fanfanlatulipe26/BaliseDGAC_GPS_Logger/img/detail_balise - Copie.jpg

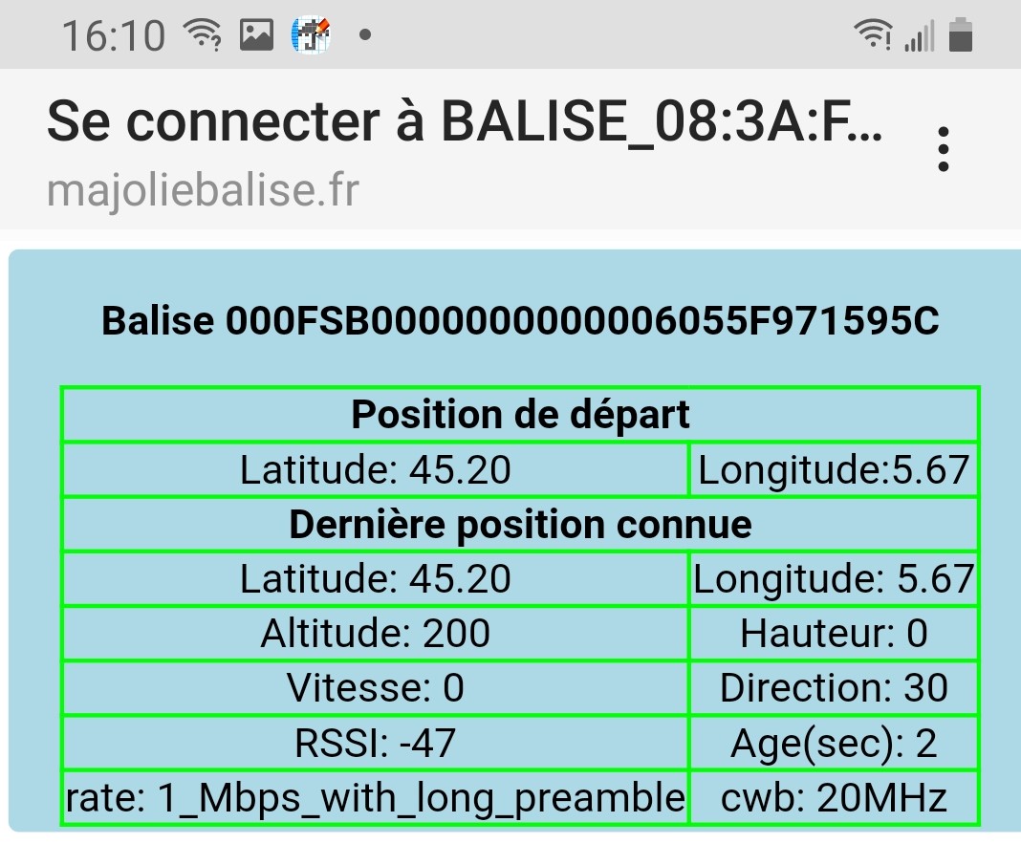
img/detail_balise - Copie.jpg
