fanfanlatulipe26/BaliseDGAC_GPS_Logger/img/recepteur_2.jpg

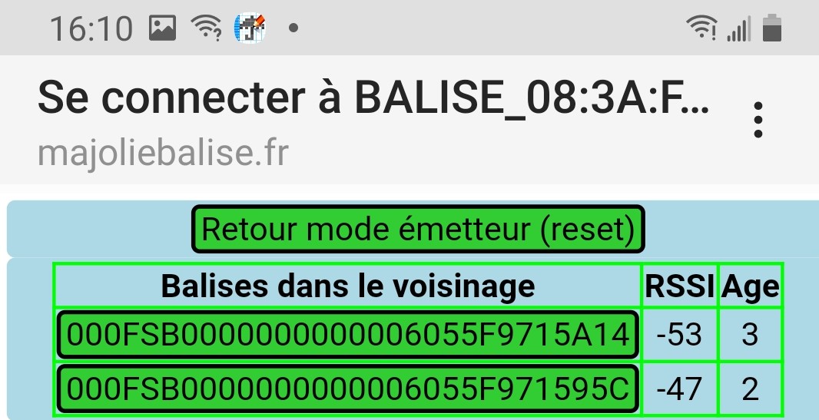
img/recepteur_2.jpg
