fanfanlatulipe26/BaliseDGAC_GPS_Logger/(threads)

Thread 6 (2023-06-19):

Pb déclaration lib SoftwareSerial.h + GPS_RX_PIN

dev-fred, 2023-06-19:
Bonjour,
Merci pour cette application très riche en fonctionnalité.
En utilisation sur ESP32 pas de problème mais sur ESP8266 D1 Mini 2 problèmes :
Mon contexte
//  Options logiciel.
#define fs_OTA        // pour permettre une mise a jour OTA pour logiciel
//#define fs_RECEPTEUR  // pour inclure aussi le code récepteur (uniquement pour une carte à base ESP32 / ESP32C3)
//#define repondeurGSM  // pour envoyer dans un SMS la position avec une module GSM SIM800L (uniquement pour une carte à base ESP32 / ESP32C3)
//#define fs_STAT     // pour avoir une page de statisques,durée exécution, erreurs GPS, etc ...Utile en phase développement ..

1) La compilation produit ces erreurs liées à un problème de déclaration de la librairie SoftSerial.h :

C:\Users\devfr\Downloads\BaliseDGAC_GPS_Logger-main\BaliseDGAC_GPS_Logger-main.ino:45:17: note: '#pragma message: Compilation pour ESP8266 !'
   45 | #pragma message "Compilation pour ESP8266 !"
      |                 ^~~~~~~~~~~~~~~~~~~~~~~~~~~~

BaliseDGAC_GPS_Logger-main:226:1: error: 'SoftwareSerial' does not name a type; did you mean 'HardwareSerial'?
  226 | SoftwareSerial serialGPS;  // pour ESP8266   softwareserial uniquement
      | ^~~~~~~~~~~~~~
      | HardwareSerial
C:\Users\devfr\Downloads\BaliseDGAC_GPS_Logger-main\BaliseDGAC_GPS_Logger-main.ino:227:17: note: '#pragma message: Utilisation de SoftwareSerial pour GPS !'
  227 | #pragma message "Utilisation de SoftwareSerial pour GPS !"
      |                 ^~~~~~~~~~~~~~~~~~~~~~~~~~~~~~~~~~~~~~~~~~
C:\Users\devfr\Downloads\BaliseDGAC_GPS_Logger-main\BaliseDGAC_GPS_Logger-main.ino: In function 'void setup()':
BaliseDGAC_GPS_Logger-main:526:3: error: 'serialGPS' was not declared in this scope
  526 |   serialGPS.begin(9600, SWSERIAL_8N1, GPS_RX_PIN, GPS_TX_PIN );
      |   ^~~~~~~~~
BaliseDGAC_GPS_Logger-main:526:25: error: 'SWSERIAL_8N1' was not declared in this scope; did you mean 'SERIAL_8N1'?
  526 |   serialGPS.begin(9600, SWSERIAL_8N1, GPS_RX_PIN, GPS_TX_PIN );
      |                         ^~~~~~~~~~~~
      |                         SERIAL_8N1
C:\Users\devfr\Downloads\BaliseDGAC_GPS_Logger-main\BaliseDGAC_GPS_Logger-main.ino: In function 'void loop()':
BaliseDGAC_GPS_Logger-main:629:10: error: 'serialGPS' was not declared in this scope
  629 |   while (serialGPS.available()) {
      |          ^~~~~~~~~
exit status 1
'SoftwareSerial' does not name a type; did you mean 'HardwareSerial'?

Que j'ai résolu en modifiant la ligne 67 BaliseDGAC_GPS_Logger.ino

#ifdef repondeurGSM
#pragma message "Code GSM!"
#include "fs_GSM.h"
#if defined (ESP8266)
#include <SoftwareSerial.h>
#endif
#endif

Par
#ifdef repondeurGSM
#pragma message "Code GSM!"
#include "fs_GSM.h"
#endif
#if defined (ESP8266)
#include <SoftwareSerial.h>
#endif

:\Users\devfr\Downloads\BaliseDGAC_GPS_Logger-main\BaliseDGAC_GPS_Logger-main.ino:45:17: note: '#pragma message: Compilation pour ESP8266 !'
   45 | #pragma message "Compilation pour ESP8266 !"
      |                 ^~~~~~~~~~~~~~~~~~~~~~~~~~~~
C:\Users\devfr\Downloads\BaliseDGAC_GPS_Logger-main\BaliseDGAC_GPS_Logger-main.ino:228:17: note: '#pragma message: Utilisation de SoftwareSerial pour GPS !'
  228 | #pragma message "Utilisation de SoftwareSerial pour GPS !"
      |                 ^~~~~~~~~~~~~~~~~~~~~~~~~~~~~~~~~~~~~~~~~~

->OK

2) Le GPS est muet
fs_options.h ligne 57
// Pour 8266 ESP8266 D1 MINI Pro

#define GPS_RX_PIN 4           // sur pin 4, label D2, brancher le fil Tx du GPS .
#define GPS_TX_PIN 5           // sur pin 5, label D1, brancher le fil Rx du GPS .(pour envoyer des commande )
NOK

#define GPS_TX_PIN 4           // sur pin 4, label D2, brancher le fil Rx du GPS .(pour envoyer des commande )
#define GPS_RX_PIN 5           // sur pin 5, label D1, brancher le fil Tx du GPS .
OK

fanfanlatulipe26, 2023-06-19:
Merci pour vos commentaires. Effectivement j’ai introduit dans cette version 4.0b1des problèmes pour l’ESP8266 lorsque j’ai fait des modifications pour l’utilisation d’un module GSM.
Le problème des exemples  de #define GPS_RX_PIN  et  #define GPS_TX_PIN pour l’ESP8266 D1 est surement très ancien : je devais toujours croiser les fils rx/tx lors de mes tests !!
Je vais reporter les modifications dans Github pour faire la version 4.0b2 et en profiter aussi pour corriger quelques Warning et autres qui existent avec  des versions récentes de compilateurs dans la librairie AsyncSMS (cette librairie a évolué mais je n’ai pas essayé d’utiliser  une version récente).
Si vous voulez tester le GSM avec un ESP8266 D1 : je ne pense pas avoir fait beaucoup de tests et ne suis pas sûr que cela fonctionne bien avec SoftwareSerial ….

PS : il doit y avoir un peu de votre code dans ce projet ;-)

dev-fred, 2023-06-19:
Je n'ai pas de GSM, mon parti pris est d'utiliser la télémétrie FSKY. En cas de crash avec perte d'alimentation, mon récepteur garde la dernière position GPS reçue comme mes quads sous INAV  et de + j'ai une très bonne porté.
Sinon, j'ai également remarqué une régression avec le GPS UBLOCK  entre la R2  où sous une période d'1 heure,  je capte 12 satellites et la R3 où j'arrive difficilement à 7 sous 8266.
En analysant le code j'ai observé que la configuration GPS CHANNELS = GPS + Galileo + Glonas avait disparu .
Étonnamment, je capte 12 satellites avec un XIAO ESP32C3+BN220  ?!
J'ai essayé d'ajouter cette configuration issue de la R2 dans la fonction fs_initGPS de la R3 mais le résultat n'est pas probant, peut être un pb de timing ou de séquencement avec le reste de la config GPS.
PS: de - en moins et c'est très enrichissant !

fanfanlatulipe26, 2023-06-22:
Je n’avais pas de système avec télémesure et je me suis donc « amusé » à rajouter le GSM, mais il est vrai qu’une télémesure avec les infos GPS gardées coté émetteur résout le problème (cela rend aussi la partie enregistrement/gestion de logs du projet très peu utile car on peut le faire éventuellement dans l’émetteur RC)
J’ai depuis peu un récepteur FlySky avec télémesure style iBus et vais éventuellement regarder cela.
Ce genre de projet me permet de toucher « pour le fun » à bien des domaines différents !!
Concernant le GPS Ublox: son support a été introduit dans la V3 et je ne crois pas avoir changé beaucoup de choses pour le GPS dans la V4. Peut être la configuration de reset sauvée en EEPROM dans le GPS a été changée ??

Thread 10 (2024-01-02):

precision position recepteur

jxl77, 2024-01-02:
Bonjour,

Je viens d'installer une balise et une autre en mode récepteur.
Tout marche bien, mais pourquoi ne pas  mettre toutes les décimales dans la position captée par le récepteur ?
où modifier pour changer cela ?

Merci

fanfanlatulipe26, 2024-01-03:
Si "identificateur" signifie nom du réseau Wifi pour le point d"accès on peut envisager de rajouter une option.
Par défaut le point d’accès serait du genre  BALISE_adresse-Mac , mais par un #define on pourrait lui donner un nom quelconque.

Par contre l'identificateur contenu dans le message envoyé par la balise doit rester lié à l'adresse MAC et être unique.

Pour retrouver un modèle après un crash et si on ne suivait pas déjà le modèle sur son portable/PC,  il faut pouvoir continuer à capter la balise, se connecter au point d'accès et récupérer les données GPS.  Cela suppose que le crash n'a pas été mortel et que la porté au sol du Wifi est suffisante (ce qui est loin d'être le cas)
Il est peut être plus intéressant si l'équipement RC le permet d'avoir une télémesure qui renvoie le GPS. On est alors sûr de récupérer les dernières coordonnées valides reçues. D’où le projet d'émuler un capteur GPS de télémesure avec la balise. Cela a été fait je crois pour Frsky et j'ai fait quelques essais avec Flysky/ibus.
L'autre solution est l'option GSM de la balise.
Voir la fin de la discussion de issue #6

jxl77, 2024-01-03:
Je ne crois pas qu'il y ait d'obligation à ce que l'identifiant soit lié à l'adresse mac. La seule contrainte est d'etre unique.
Si je fait commencer l'identificateur  par mon indicatif de telepilote, puis un identifiant unique à mon send, le tout sera unique.

Pour la  recherche après crash, j'ai la pratique de recherche de ballons sondes, avec un émetteur  401Mhz qui envoie les coordonnées GPS.  Bien sur le fin du fin est davoir un retour des coordonnées sur une carte openstret map.
Mais au besoin, on peut reporter  les coordonnées à la main.
Pour la portée, il faut bien sur avoir une idée approximative de l'endroit, et une bonne antenne sur son recepteur.

fanfanlatulipe26, 2024-01-06:
Je viens de créer sur GitHub une nouvelle branche [travail-4.2](https://github.com/fanfanlatulipe26/BaliseDGAC_GPS_Logger/tree/travail-4.2) qui contient la possibilité de modifier l'identifiant de la balise et une option pour rajouter de la télémétrie FLysky/IBus.
24 caractères sont disponibles Les 6 premiers sont figés.
Le n° UAS faisant 16 caractères, il reste 8 caractères pour infos supplémentaires.

Le soft permettait déjà de changer le nom du réseau Wfi pour le point d'accès.

Reste peut être un problème si on utilise le N° UAS dans l'identificateur: je ne sais pas si 2 N° UAS peuvent différer uniquement par des caractères en majuscule/minuscule.
Pour l'identificateur de la balise, l'arrêté du 27 décembre 2019 précise bien que la "casse" n'est pas prise en compte:
`Cet identifiant unique ne doit comporter aucun signe espace. En outre, l'unicité de cet identifiant ne pourra être obtenue en prenant en compte la sensibilité à la casse pour discriminer deux identifiants uniques différents.`

jxl77, 2024-01-06:
Meilleurs Voeux, et merci pour vos efforts.
J'ai poursuivi un peu mes expérimentations. J'ai toutes les peines du monde à faire l'upload avec Arduino IDE 2.0.
Le port série se déconnecte tout le temps alors que esptool.py marche très bine seul.
J'ai donc laissé tomber et repris avec  Plateformeio en mode linge de commande.
Cela marche beaucoup mieux.
J'ai pu compiler pour diverses plateformes (Attention, il y a un but qui a été introduit il y a deux jours dans softwareserial).
Pas de problème pour les divers ESP32 Devkit V1.
En revanche, j'ai bien compilé, et fait l'upload sur un ESP32S3  (lolin_s3) et un ESP32S2  D1 mini, (lolin_s2_mini )
Mais cela ne marche pas. Je prends les configs les plus proches de ce que j'ai.
Mais il n'y a pas tout.  Mon ESP32S2 mini est de Wemos
Le  ESP32S3, je ne sais pas trop.

fanfanlatulipe26, 2024-01-06:
J'utilise IDE 1.8.19 sur PC avec le package ESP32 2.0.11 et n'ai pas de problèmes particuliers. J'ai laissé tomber IDE 2 car je trouvais certaines limitations actuelles (?) trop bloquantes. Avez vous essayé le chargement par OTA: cela marche très bien pour moi.
Il y a longtemps que je n'ai pas testé sur ESP8266 avec softwareserial.  J'ai trouvé aussi un très gros problème avec ESP32-C3 et le développeur a du faire de gros changements depuis pour supporter le C3 (le C3 a une horloge qui change dynamiquement a la différence des autres ESP ...). J'ai pour le moment abandonné espsoftwareserial pour les ESP32.

Je n'ai pas testé sur  ESP32S3 et ESP32S2,  mais je pense que la partie point d'accès Wifi devrait fonctionner. A suivre  ...

jxl77, 2024-01-07:
Sur  le ESP32S3,  j'ai maintenant pu faire compilation et upload,  sur platformio mais
cela ne marche pas. voici le message d'erreur qui vient de la liaison serie

entry 0x403c98d0
E (27) uart: uart_set_pin(692): tx_io_num error
ESP_ERROR_CHECK failed: esp_err_t 0xffffffff (ESP_FAIL) at 0x4037d474
file: "******/.platformio/packages/framework-arduinoespressif32/cores/esp32/esp32-hal-uart.c" line 214
func: uartBegin
expression: uart_set_pin(uart_nr, txPin, rxPin, UART_PIN_NO_CHANGE, UART_PIN_NO_CHANGE)

abort() was called at PC 0x4037d477 on core 1

jxl77, 2024-01-07:
j'ai testé la nouvelle version. 4.1b1
J'ai pu  très facilement changer l'Identificateur. C'était important pour moi car je voulais conserver l'identificateur déclaré sur alphatango avant le 31 décembre. Merci pour cette correction.
J'ai mis le recepteur sur un Lolin32 Lite.  Balise sur Wemos D1 V4.

fanfanlatulipe26, 2024-01-08:
Erreur sur  ESP32S3 semble indiquer un problème avec la définition des pins pour le GPS  GPS_RX_PIN/GPS_TX_PIN

fanfanlatulipe26, 2024-02-04:
Résolu avec 4.2

jxl77, 2024-02-05:
C'est noté. Merci. Je ferai les essais dès que j'aurai un peu de temps libre.

Closed 2024-02-04.

Thread 18 (2024-03-31):

Balise réglementation

Mozzytec, 2024-03-31:
Bonjour
Tout d'abord félicitations pour le travail effectué.
POur ma part : la compilation est faite sous arduino 2.1.0 avec le package ESP 2.0.11 (byespressif)
L'esp est un Lyligo ESP01-C3 + GPS L80 quectel.
Pour info (écrit nulle part) pour le flasher il faut relier l'Io9 au GND pour le forcer en mode bootloader
La balise fonctionne bien, le portail aussi sur Android.

Juste une crainte sur la réglementaion et notamment sur le fait de pouvoir changer l'identifiant.
Ce n'est pas tant le fait qu'il faut qu'il reste unique (simple avec l'UUID de la puce) mais plutôt le fait que la réglementation précise
"_Le dispositif de signalement électronique ou numérique mentionné à l'alinéa premier de l'article L. 34-9-2 et à l'[article R. 20-29-2 du code des postes et des communications électroniques] est programmé au cours de sa production et ne dispose d'aucune possibilité de modification de ses réglages par un tiers pour les champs identifiés comme obligatoires dans le présent arrêté_"

Pour être parfaitement en ligne peut être serait il nécessaire de n’accéder au champ modification de l'identifiant qu'avec un mot de passe?
Question egalement sur le respect de la bande des 20MHz est ce le cas sur cette version?

fanfanlatulipe26, 2024-03-31:
Merci de l’intérêt que vous portez à ce projet.
Oui, pouvoir modifier l’ID de la balise est surement un peu limite réglementairement… et je m’étais posé la question en rajoutant cette fonctionnalité de la mettre en option.
A l’utilisateur d’être responsable et de gérer ses identificateurs en fonction de ce qui est enregistré dans AlphaTango
Dans la version actuelle de la balise, le réseau wifi créé peut avoir un mot de passe et cela nous protège d’une connexion malveillante sur l’interface pour modifier les paramètres de la balise…
Enfin, on en revient toujours  un peu à l’utilité finale de cette balise. Si quelqu’un veut voler sans se faire repérer il ne va pas mettre une balise !

Concernant la largeur des canaux wifi:
Je n’ai pas trop regardé la partie wifi/beacon frame et me suis basé sur les travaux déjà publiés pour ce projet. En mode récepteur, on affiche quelques caractéristiques de la frame beacon et en particulier la largeur de canal (CWB) qui est trouvée à 20Mhz : on doit donc être bon.

L’ESP01 C3 est sympa comme carte car il permet une réalisation très petite : sa programmation n’est pas très aisé mais l’utilisation de mises à jour par OTA est dans ce cas très pratique.
Il y a aussi les cartes Seeed Studio XIAO ESP32S3, ou ESP32 C3 SuperMini  très petites aussi, avec bien plus de pins accessibles et un connecteur USB, mais  nécessitant une antenne externe.
