fanfanlatulipe26/BaliseDGAC_GPS_Logger/fsBalise.h

/*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
    You should have received a copy of the GNU General Public License
    along with this program.  If not, see <https://www.gnu.org/licenses/>.
*/
/*------------------------------------------------------------------------------
*/
#ifdef ESP32
#include "fs_WebServer.h"
#else
#include <ESP8266WebServer.h>
#endif

#include <TinyGPS++.h>

const char versionSoft[] = "4.2";
#define DEBUG_HEAP false
//#define DEBUG_HEAP true
#ifndef ESP32
#define dbgHeap(mes) \
  do { if (DEBUG_HEAP) Serial.printf_P(PSTR("%s %s():%d  FreeContStack: %5d  free: %5d - max: %5d - frag: %3d%% \n "),\
                                           mes, __func__, __LINE__,ESP.getFreeContStack(),\
                                           ESP.getFreeHeap(), ESP.getMaxFreeBlockSize(),\
                                           ESP.getHeapFragmentation());} while (0)
#else
#define dbgHeap(mes) \
  do { if (DEBUG_HEAP) Serial.printf_P(PSTR("%s %s():%d free: %5d \n "),\
                                           mes, __func__, __LINE__,\
                                           ESP.getFreeHeap());} while (0)
#endif

// voir pour adresse DNS 8.8.8.8 FS https://github.com/espressif/arduino-esp32/issues/1037
//  pour Android ??
//enum { traceNone, traceGPX, traceCSV };
struct pref { // preferences sauvées en EEPROM
  char signature[6] = "edg";  // signature d'une EEPROM balise. A changer si on change les valeurs par defaut ou le format des references
  //  char signature[6] = "ablfs";  // balfs  signature d'une EEPROM balise. Ne pas toucher
  char password[9] = ""; //  Par défaut le réseau créé est ouvert
  char SMSCommand[9] = ""; //  Par défaut on met toujours les coordonnées dans le SMS envoyé
  char ssid_AP[33] = ""; // Par défaut le ssid du point d'accés crée sera basé sur l'adresse MAC
  // Ne pas toucher drone_id !!
  char drone_id[31] = "000FSB000000000000YYYYYYYYYYYY"; // les YY seront remplacés par l'adresse MAC, sans les ":"
  //  000   trigramme constructeur "amateur"
  //  FSB   mon modèle de balise
  //  24 octets pour l'identificateur
  //   valeurs de l'exemple CaptivePortal
  char local_ip[16] = "8.8.4.4"; // The default android DNS
  char gateway[16] = "8.8.4.4" ;
  char subnet[16] = "255.255.255.0";

  int timeoutWifi = 45;  // delais deconnection AP wifi
  int logAfter = 5 ;   // enregistrement d'un point si déplacement de 5m  (si <0, enregistrement après n millis sec)
  int baud = 9600;  // vitesse de transmission avec le GPS   19200 ((OK avec ESP8266), 38400
  int nbrMaxTraces = 10; // nobre maximal de traces à conserver
  byte hz = 1;  //  taux de rafraichissement du GPS
  char formatTrace[4] = "csv";  //  csv gpx
  bool logOn = true;  // true: on enregistre; false: pas de trace enregistrée
  bool logToujours = true; // enregistrerla trace même si on ne se déplace pas
  bool logVitesse = false;
  bool logAltitude = true;
  bool logHeure = true;
  bool arretWifi = true;  // false: ne pas arreter le point d'accès Wifi en vol;  true: arreter le point d'accès
  bool basseConso = false;  // true: couper le wifi entre 2 trames.
  bool iBusActif = true ; // pour telémesure style FlySky. L'activation dépend de toute façon de l'option define fs_iBus dans fs_option.h
};
// type pour structure servant à stocker en binaire une ligne (un point) du log de trace: 20 octets par point
struct trackLigne_t {
  float lat;  // double pas nécessaire ...
  float lng;
  uint8_t hour;
  uint8_t minute;
  uint8_t second;
  uint8_t centisecond;
  float altitude; // double pas necessaire ...
  float speed;
  float VmaxSegment; // vitesse max vue entre ce point et le point précédent
  float AltMaxSegment;
};

// type pour un bloc d'info de statistiques
struct statBloc_t {
  char nom[25];
  int min, max, total, sousTotal, count;
  long T0;
  float moyenneLocale;
};

bool fs_ecrireTrace(TinyGPSPlus &gps);
bool removeOldest();
bool loadFromSPIFFS(String path);
void sendChunkDebut ( bool avecTopMenu );
void handleCockpit();
void handleGiveMeTime();
void handleRazVMaxHMAx();
void handleCockpitNotFound();
void listSPIFFS(String message);
void handleDelete();
void handleFileInfo();
void handleFormatage();
void gestionSpiff(String message);
void handleGestionSpiff();
void handleNotFound();
void checkFactoryReset();
void readPreferences();
void savePreferences();
void listPreferences();
void handleOptionLogProcess();
void handleOptionGPSProcess();
void handleOptionPointAccesProcess();
void handleOptionSMSCommand();
void handleOptionIBUS();
void handleOptionsPreferences();
void handleResetUsine();
void handleDroneID();
void handleReset();
void handleFavicon();
void handle_generate_204();
void fs_initServerOn( );
void displayOptionsSysteme(String sms);
void handleOptionsSysteme();
void handleOTA_();
void handleResetStatistics();
void razStatistics();
void nettoyageTraces();
void razStatBloc(statBloc_t* bl);
void calculerStat (boolean calculerTemps, statBloc_t * bl);
int writeStatBloc(char buf[], int size, statBloc_t* bl);
#ifdef ESP32
void  fs_initServerOnOTA(fs_WebServer &server);
#else
void  fs_initServerOnOTA(ESP8266WebServer &server);
#endif
void logError(TinyGPSPlus &gps, float latLastLog, float lngLastLog, float segment);
void logRingBuffer(char ringBuffer[], int sizeBuffer, int indexBuffer);
