fanfanlatulipe26/BaliseDGAC_GPS_Logger/fs_GSM.cpp

/*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
    You should have received a copy of the GNU General Public License
    along with this program.  If not, see <https://www.gnu.org/licenses/>.
*/
#include "fsBalise.h"
#include "fs_options.h"
#include "fs_GSM.h"
#include "AsyncSMS.h"
#include <SoftwareSerial.h>

//#if defined(repondeurGSM) && !defined(ESP32)  //++++++++++++++++++++++++++++++++++++++++++++++++++++++++++++++++++
//#error "Option repondeurGSM valide uniquement avec une carte ESP32/ESP32C3"
//#endif
#ifdef repondeurGSM  //  compilation conditionnelle de tout le code GSM
extern double lat_prev;
extern double lon_prev;
extern pref preferences;
#if defined(ESP32)
#if defined (CONFIG_IDF_TARGET_ESP32C3)
HardwareSerial GSMSerial(0);   // UART 0 sur ESP32C3 pour GSM  ... Plus de debug !!
#pragma message "Utilisation de HardwareSerial 0 pour GSM sur ESP32C3!. Plus de SerialMonitor /debug !!"
#else
HardwareSerial GSMSerial(2);   // UART 2 sur ESP32 ( pour GSM
#pragma message "Utilisation de HardwareSerial 2 pour GSM !."
#endif
#else   // software serial pour ESP8266
SoftwareSerial GSMSerial;
#pragma message "Utilisation de SotfwareSerial pour GSM !"
#endif

AsyncSMS smsHelper(&GSMSerial);
//AsyncSMS smsHelper(&GSMSerial, true);  // autoStateRefresh ??

void processingLogger(const char *msg) {
  Serial.println(msg);
}

void SMSReceived(char * number, char * message) {
  // lon = 2.294427;
  char smsBuffer[250];
  //Serial.printf_P(PSTR("SMS message received from %s: %s\n---------  SMS end -----------\n"), number, message);
  if ( strcmp(message, preferences.SMSCommand) == 0 || strlen(preferences.SMSCommand) == 0) {
    // send your location only if received SMS contains a secret sentence...
    sprintf_P(smsBuffer, PSTR( "Hi , I am here: https://www.google.com/maps/search/?api=1&query=%f%%2C%f"), lat_prev, lon_prev);
  }
  else
    sprintf_P(smsBuffer, PSTR("Hi , I am still alive !"));
  // Serial.printf_P(PSTR("SMS reply: %s\n"), smsBuffer);
  smsHelper.send(number, smsBuffer);
}
void GSMInit()
{
  Serial.print(F("Lecture venant du GSM sur pin ")); Serial.println(GSM_TX);
  Serial.print(F("Ecriture vers le GSM sur pin ")); Serial.println(GSM_RX);
  delay(10000);  // attente init GSM ... ???
#if defined(ESP32)
#if defined (CONFIG_IDF_TARGET_ESP32C3)
  Serial.println("Arret de Serial ..");
  Serial.flush();
  Serial.end();
#endif
  GSMSerial.begin(57600, SERIAL_8N1, GSM_TX, GSM_RX);  // attention !! Des pbs si vitesse faible ??  OK esp32
#else   // software serial pour ESP8266
  GSMSerial.begin(19200, SWSERIAL_8N1, GSM_TX, GSM_RX);  //

#endif
  if (!GSMSerial) { // If the object did not initialize, then its configuration is invalid
    Serial.println(F("Invalid SoftwareSerial pin configuration, check config"));
  }
  //  SerialGSM.println("AT");  SerialGSM.println("AT");
  smsHelper.smsReceived = *SMSReceived;
  smsHelper.logger = *processingLogger; // pour debug ...
  smsHelper.init();
  smsHelper.process();   // il faudrait pouvoir attendre la fin de la sequence d'init ....
  smsHelper.deleteAllSMS();
}


void GSMCheck()
{
  smsHelper.process();
}
#endif
