fanfanlatulipe26/BaliseDGAC_GPS_Logger/fs_recepteur.h

void handleRecepteur();
void loopRecepteur();
void handleRecepteurRefresh();
void handleRecepteurDetail();
static void initialize_wifi_sniffer();
//static void wifi_sniffer_cb(void *recv_buf, wifi_promiscuous_pkt_type_t type);
