fanfanlatulipe26/BaliseDGAC_GPS_Logger/(commit log)

2021-03-18 Rename BaliseDGAC_GPS_Logger_V1.ino to BaliseDGAC_GPS_Logger.ino
    Pas de version dans le file name
2022-03-19 Pour v3 (#3)
    * Update README.md
    * Update README.md
    * Update README.md
    * Add files via upload
    * Update README.md
    * Update README.md
    * Create README.md
    * Add files via upload
    * Delete traces.png
    * Delete OTA.png
    * Delete cockpit_LI.jpg
    * Delete preferences.png
    * Update README.md
    * Update README.md
    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
2023-06-19 Pour v4.0b2 (#7)
    Changes for 4.0b2
    * Delete AsyncSMS.cpp
    * Delete AsyncSMS.h
    * Delete BaliseDGAC_GPS_Logger.ino
    * Delete fs_options.h
    * pour v4.0b2
    corrections warning dans AsyncSMS.h et AsyncSMS.cpp
    correction problème N° #6 déclaration lib SoftwareSerial.h + GPS_RX_PIN
    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
    [AsyncSMS.cpp, AsyncSMS.h, BaliseDGAC_GPS_Logger.ino, fs_options.h]
2024-01-24 Update fs_WebServer.h
    Rajout d'un constructeur fs_WebServer(IPAddress addr, int port) pour avoir les même constructeur que Webserver.h original.
2025-12-27 Update README .
    Added a warning about compilation issues with ESP32 3.x.x.
2026-01-01 Update README with beacon power supply details
    Remarque ajoutée sur l'alimentation de la balise
